ajpasic/Knuckles/Pictures/IMG_0444.JPG

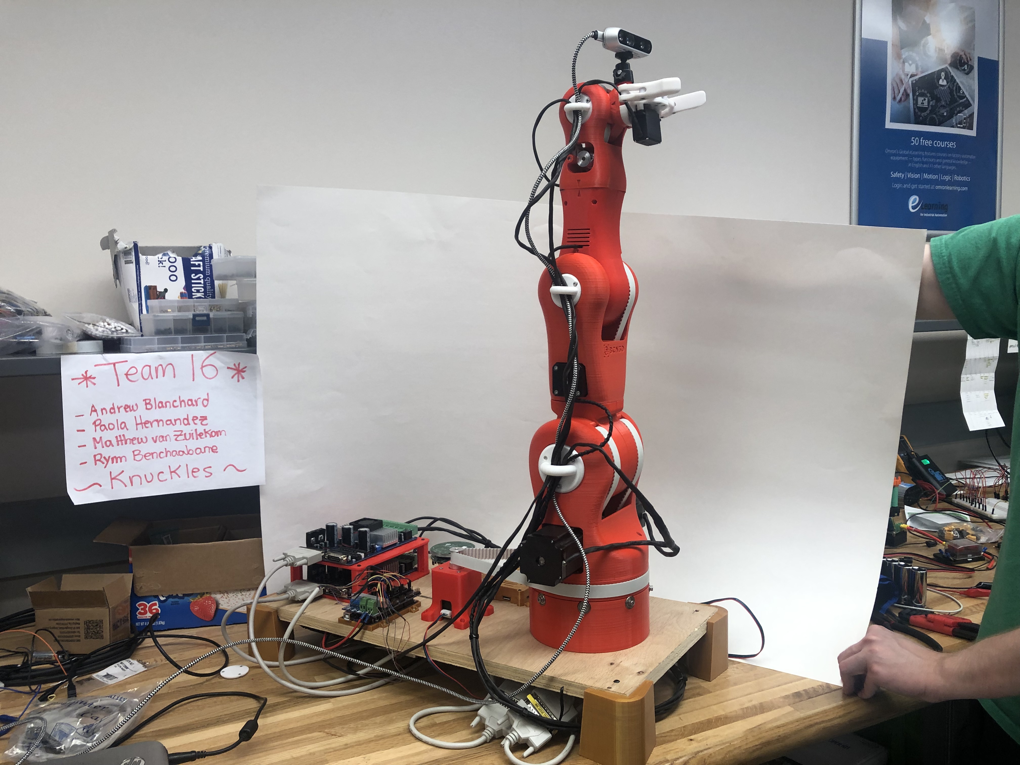
Pictures/IMG_0444.JPG
