ajpasic/Knuckles/Pictures/IMG_0445.JPG

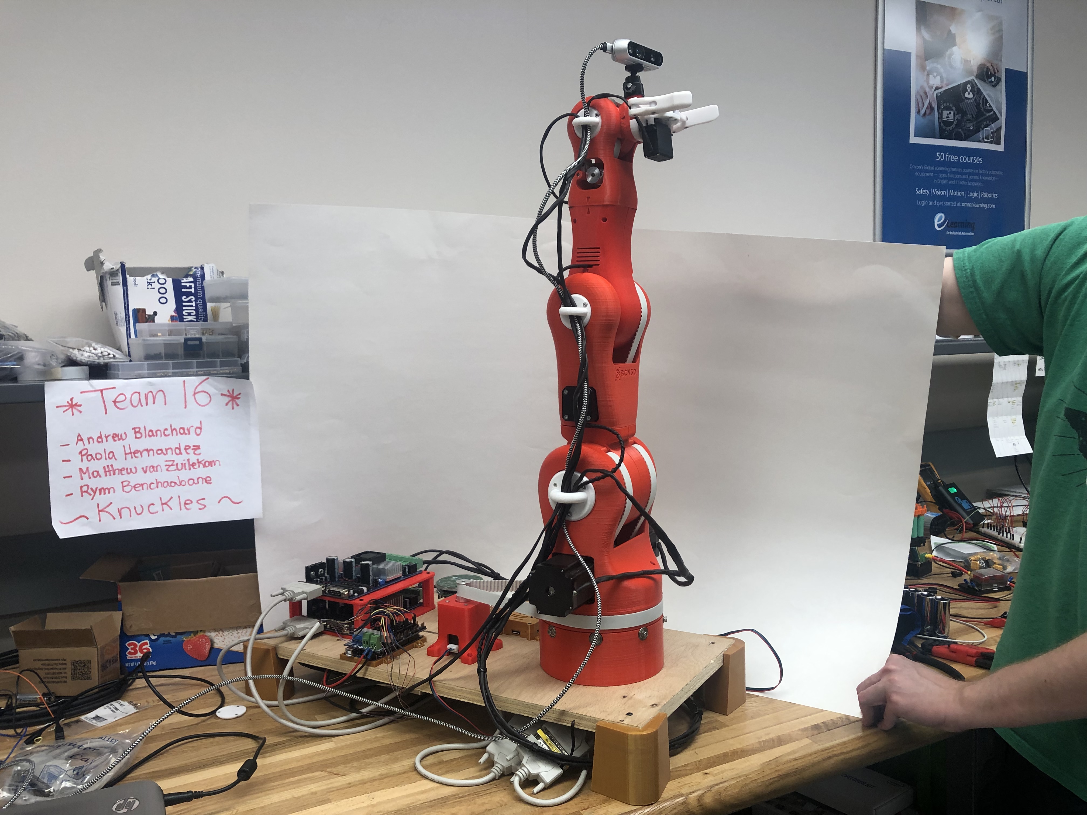
Pictures/IMG_0445.JPG
