ajpasic/Knuckles/README.md

# Knuckles
IEEE/ASME Knuckles Collaboration
