ajpasic/Knuckles/Pictures/IMG_0446.JPG

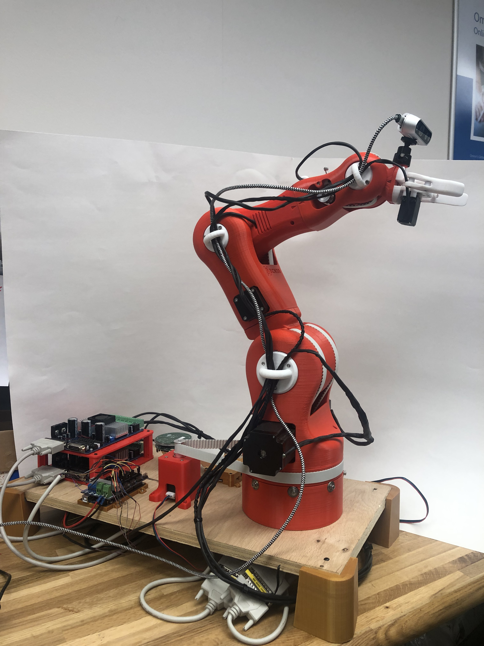
Pictures/IMG_0446.JPG
