ajpasic/Knuckles/Pictures/IMG_0447.JPG

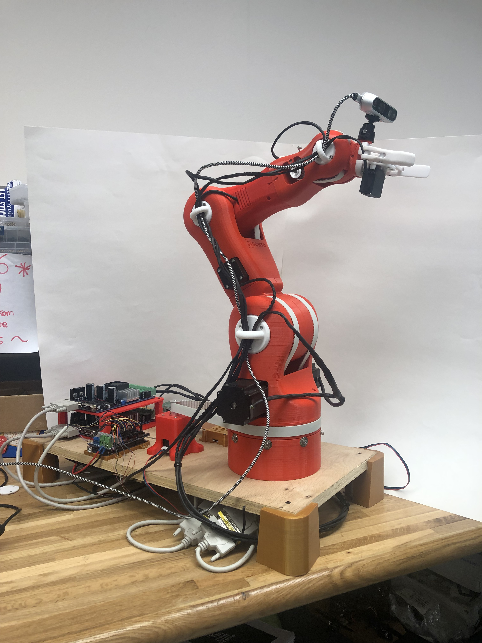
Pictures/IMG_0447.JPG
