ajpasic/Knuckles/Pictures/IMG_0448.JPG

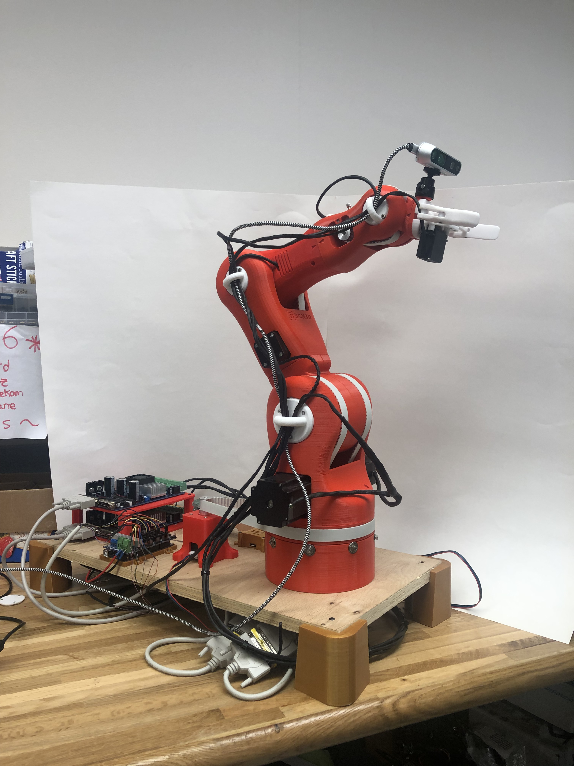
Pictures/IMG_0448.JPG
