ajpasic/Knuckles/Pictures/IMG_0449.JPG

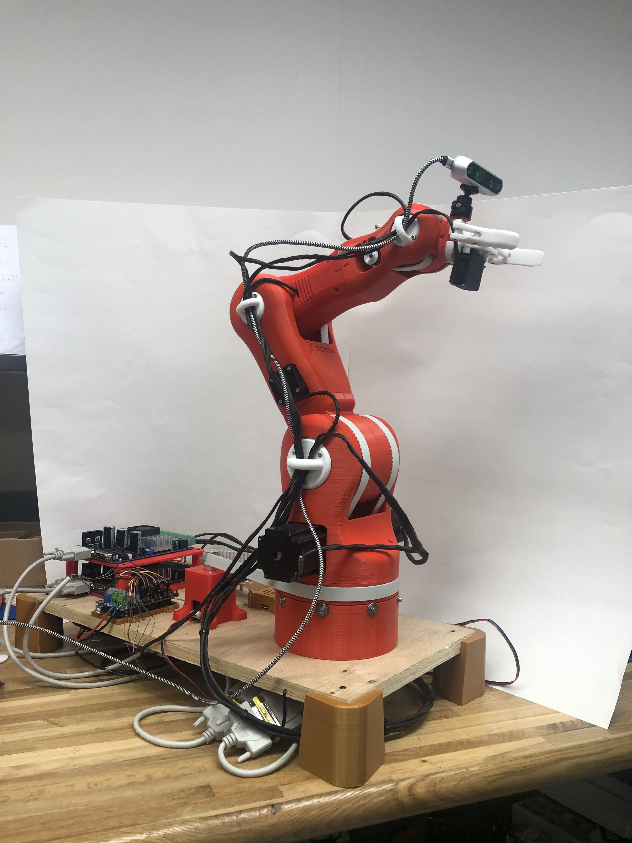
Pictures/IMG_0449.JPG
