ajpasic/Knuckles/Pictures/IMG_0450.JPG

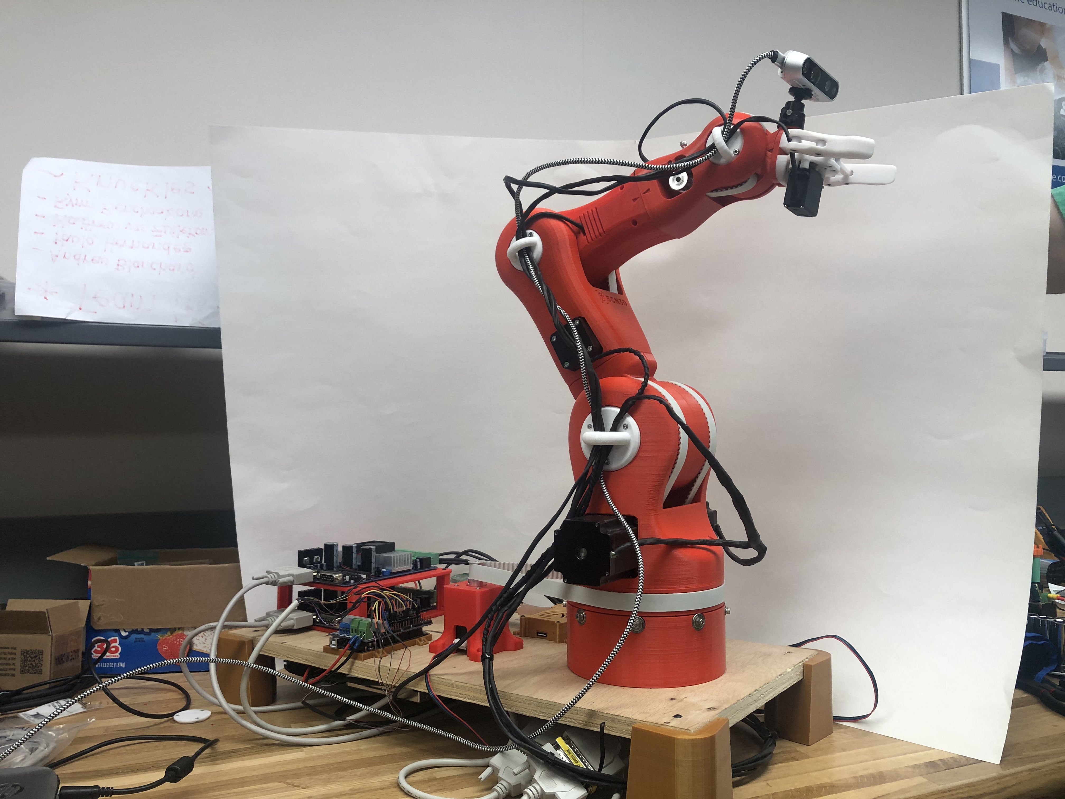
Pictures/IMG_0450.JPG
