ajpasic/Knuckles/Pictures/IMG_0451.JPG

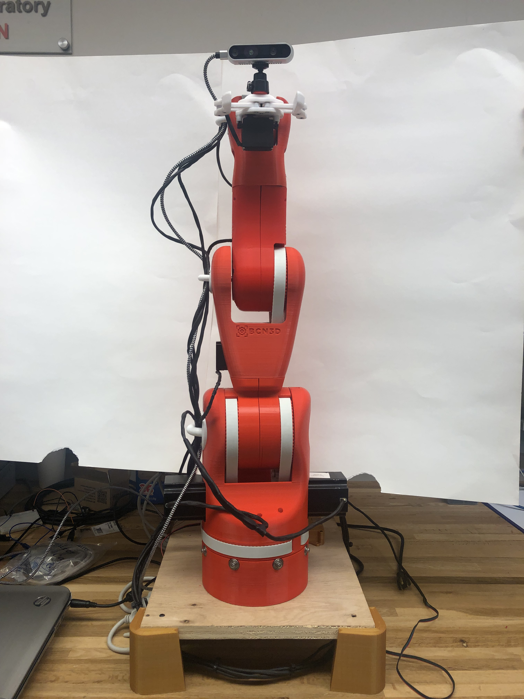
Pictures/IMG_0451.JPG
