ajpasic/Knuckles/Pictures/IMG_0452.JPG

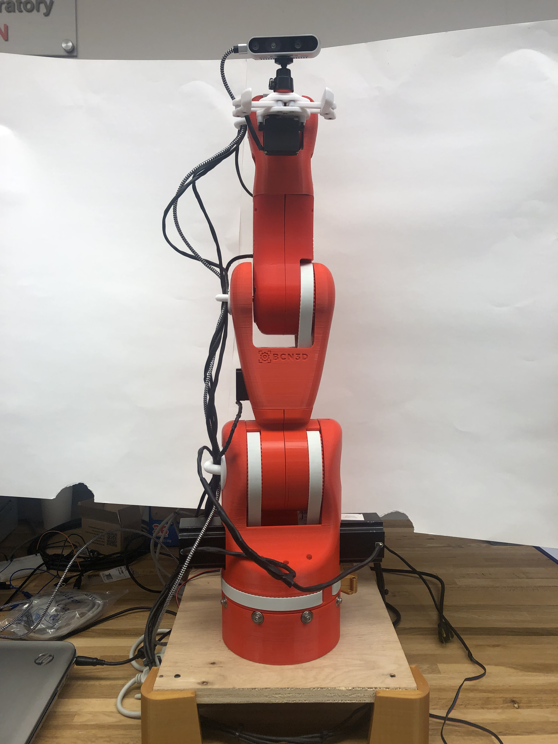
Pictures/IMG_0452.JPG
