ajpasic/Knuckles/Pictures/IMG_0455.JPG

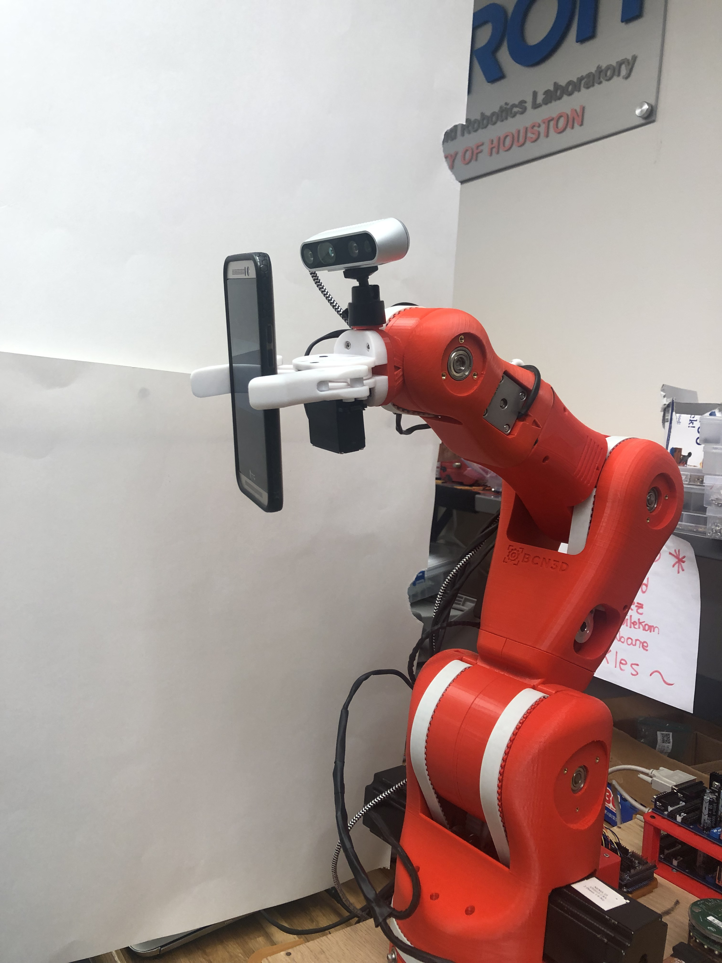
Pictures/IMG_0455.JPG
