ajpasic/Knuckles/Pictures/IMG_0456.JPG

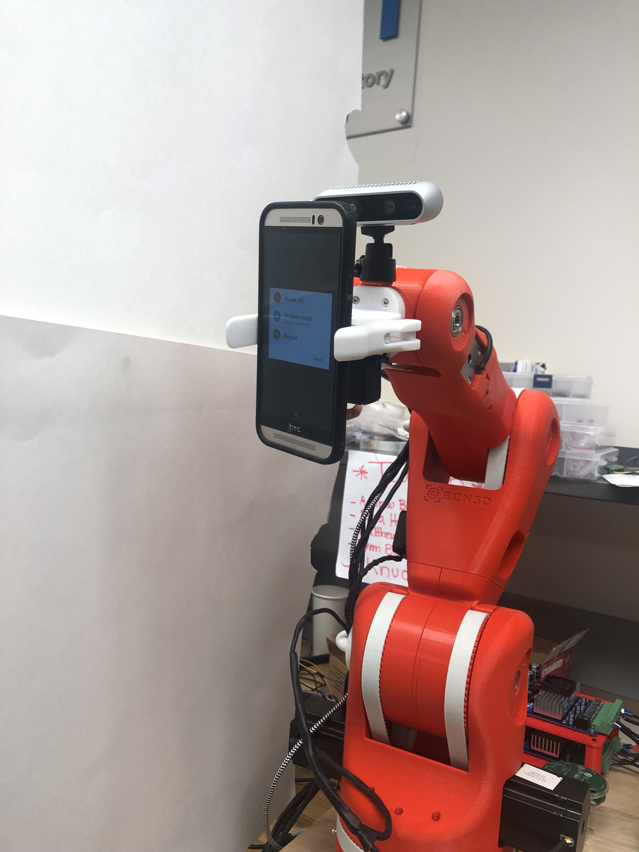
Pictures/IMG_0456.JPG
