ajpasic/Knuckles/Pictures/IMG_0457.JPG

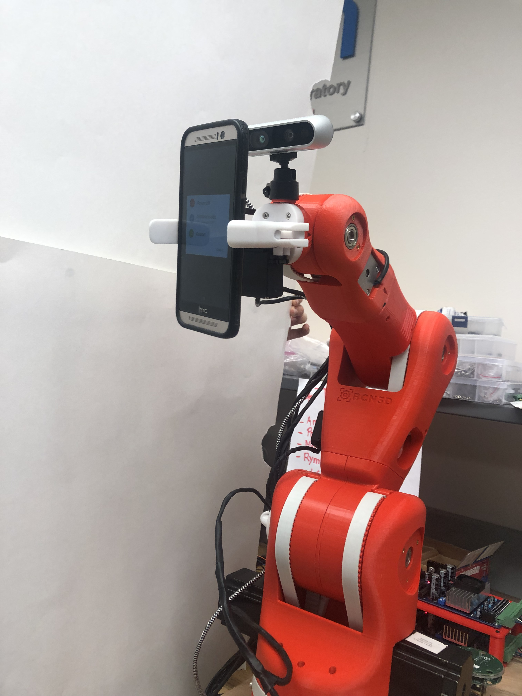
Pictures/IMG_0457.JPG
