ajpasic/Knuckles/Pictures/IMG_0458.JPG

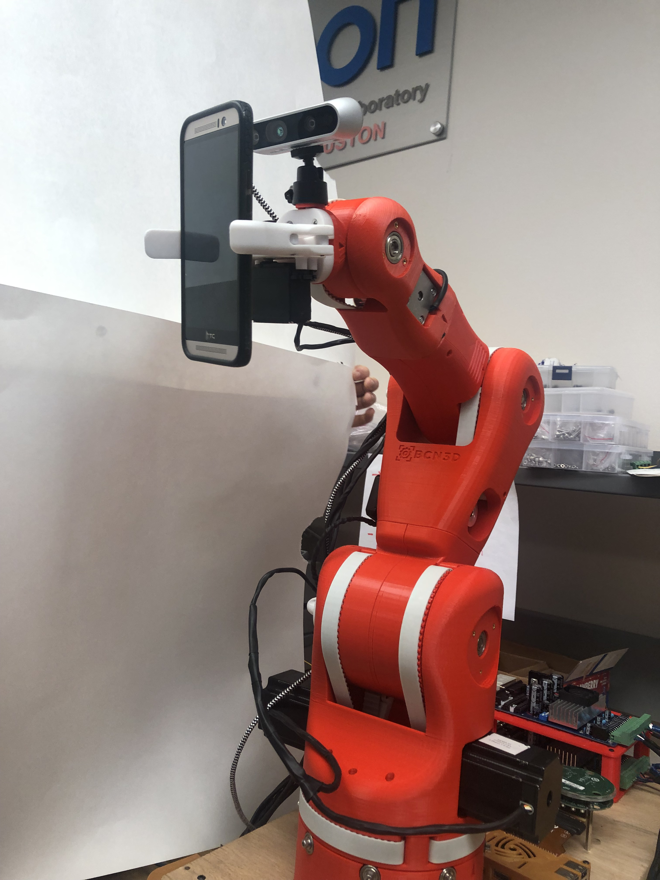
Pictures/IMG_0458.JPG
