ajpasic/Knuckles/Pictures/IMG_0459.JPG

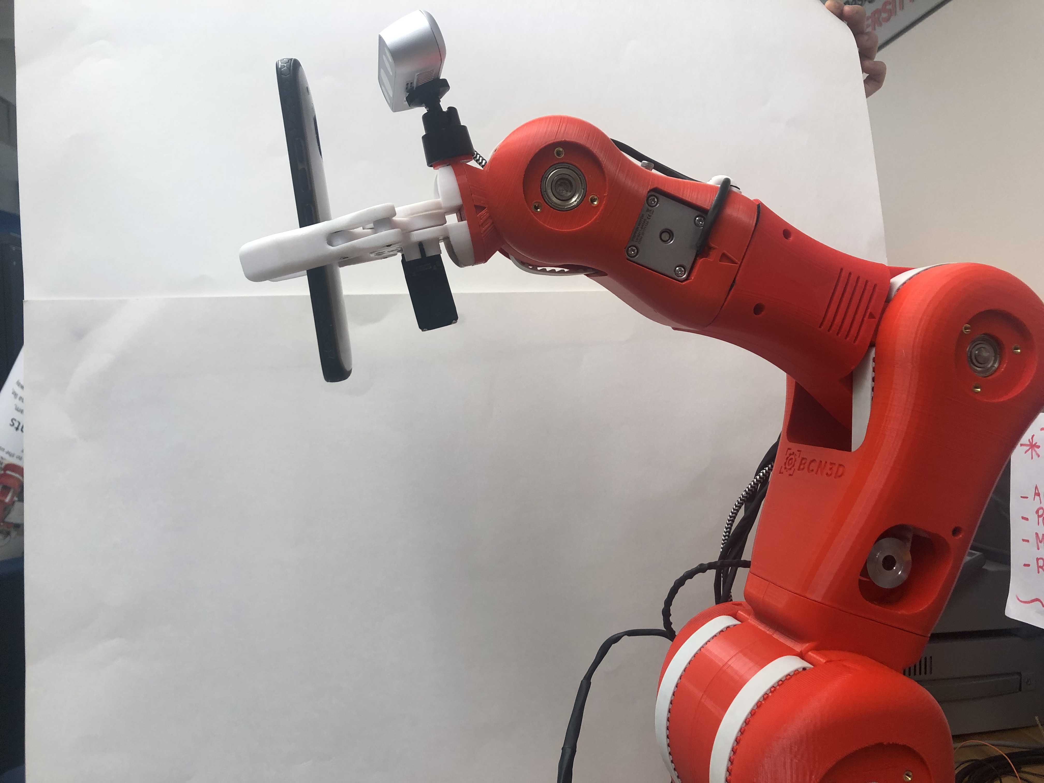
Pictures/IMG_0459.JPG
