ajpasic/Knuckles/Pictures/IMG_0460.JPG

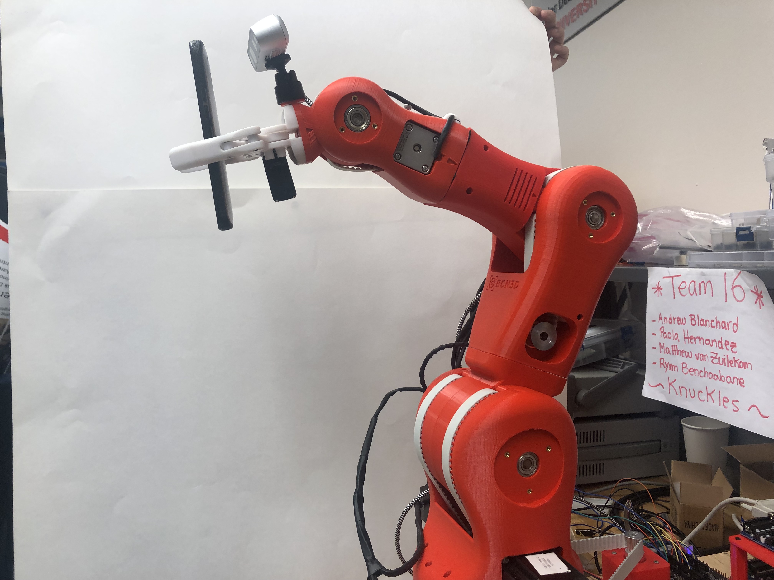
Pictures/IMG_0460.JPG
