ajpasic/Knuckles/Pictures/IMG_0461.JPG

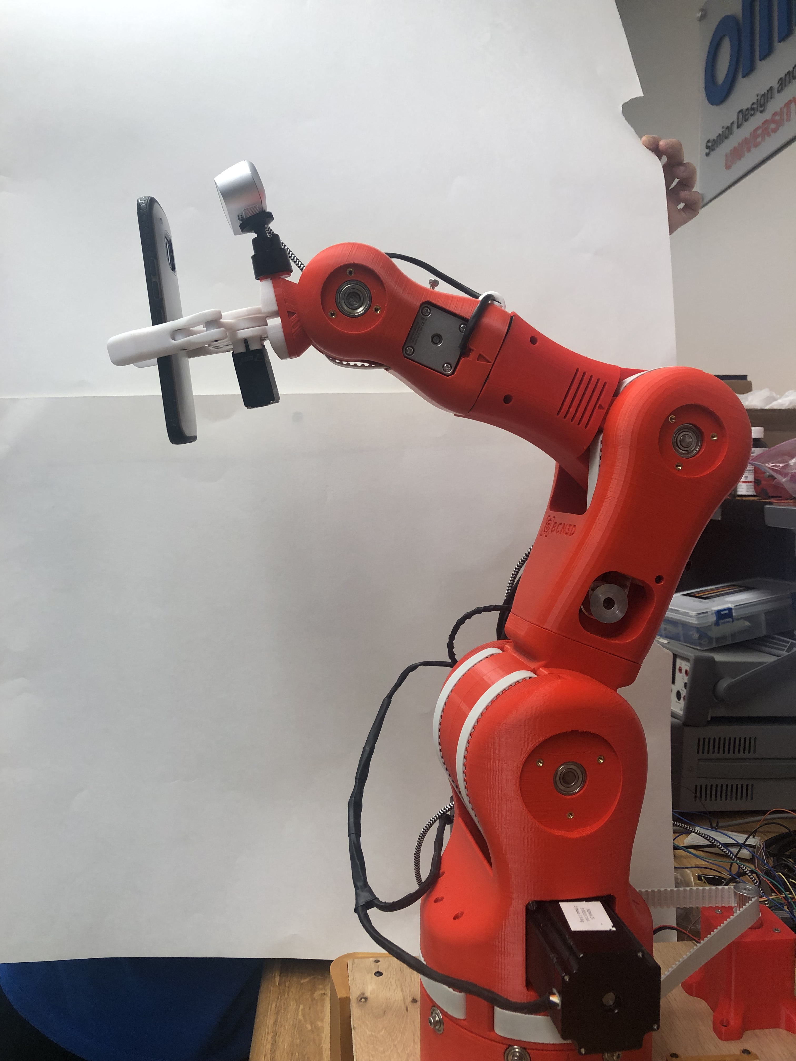
Pictures/IMG_0461.JPG
