ajpasic/Knuckles/Pictures/IMG_0462.JPG

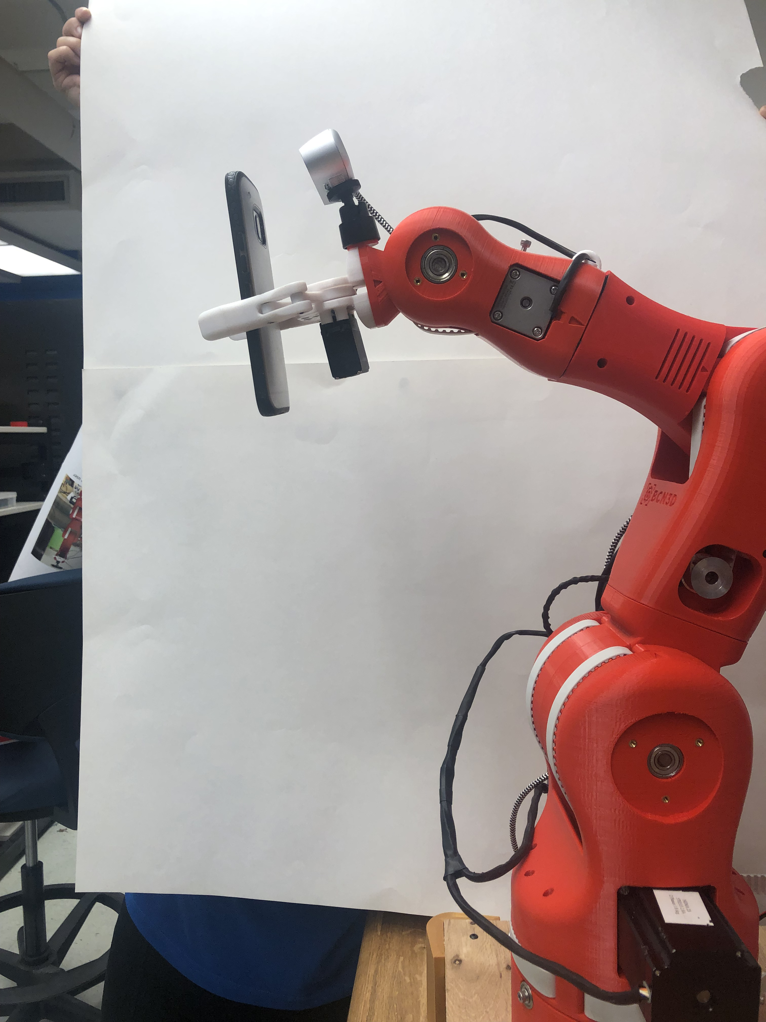
Pictures/IMG_0462.JPG
