ajpasic/Knuckles/Pictures/IMG_0463.JPG

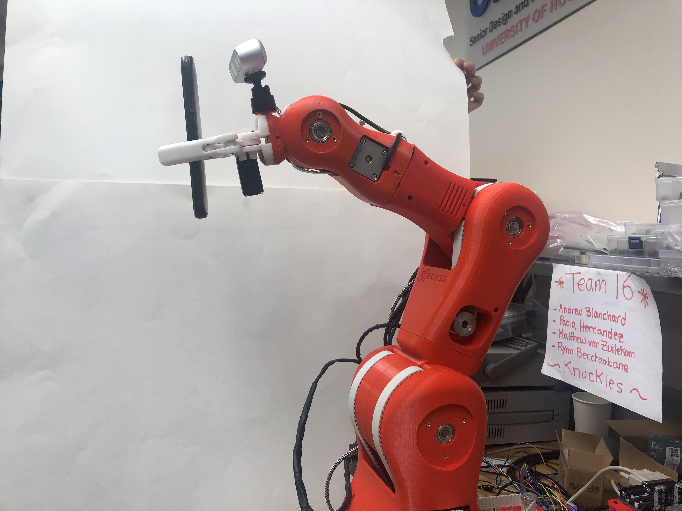
Pictures/IMG_0463.JPG
