ajpasic/Knuckles/Pictures/IMG_0464.JPG

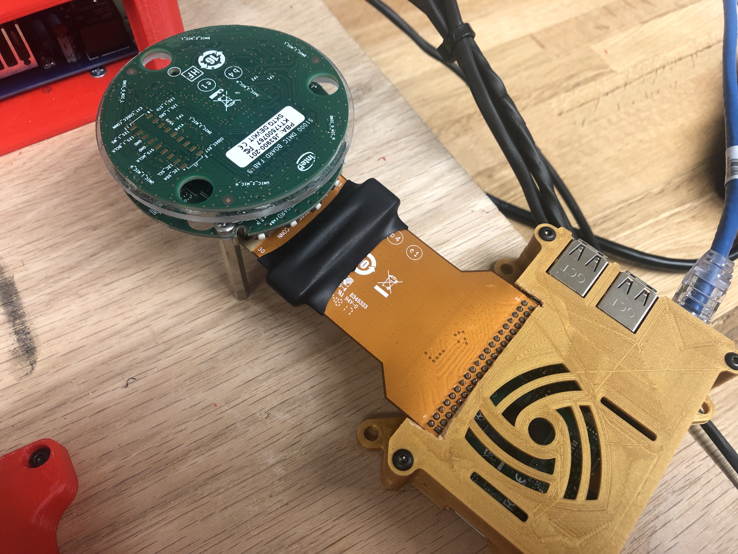
Pictures/IMG_0464.JPG
