ajpasic/Knuckles/Pictures/IMG_0465.JPG

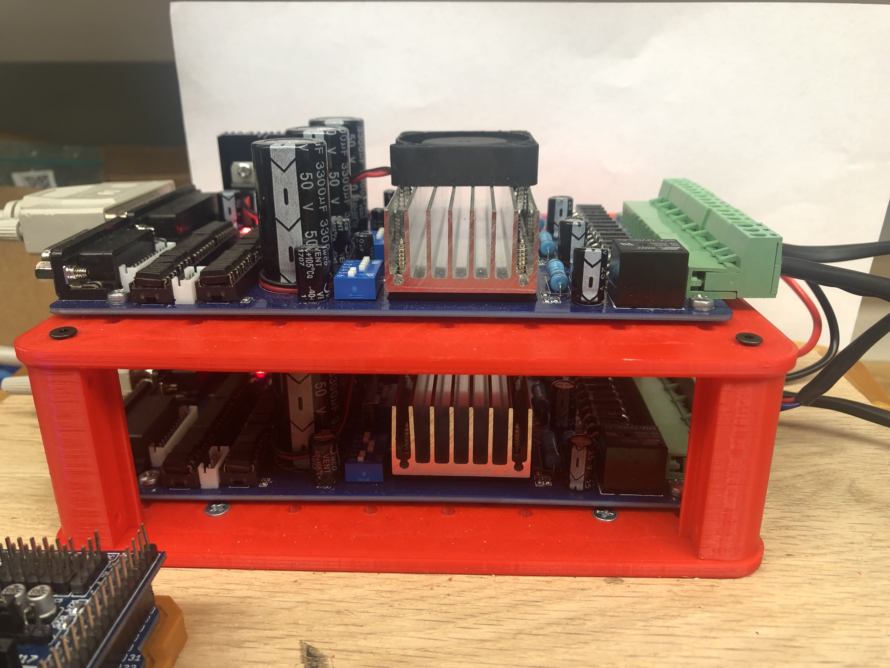
Pictures/IMG_0465.JPG
