ajpasic/Knuckles/Pictures/IMG_0466.JPG

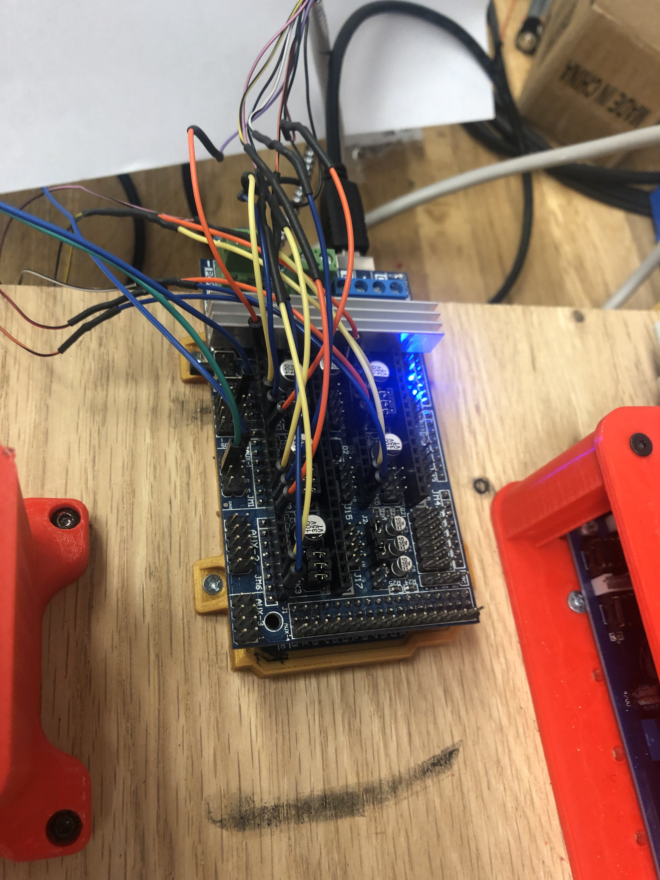
Pictures/IMG_0466.JPG
