ajpasic/Knuckles/Pictures/IMG_0467.JPG

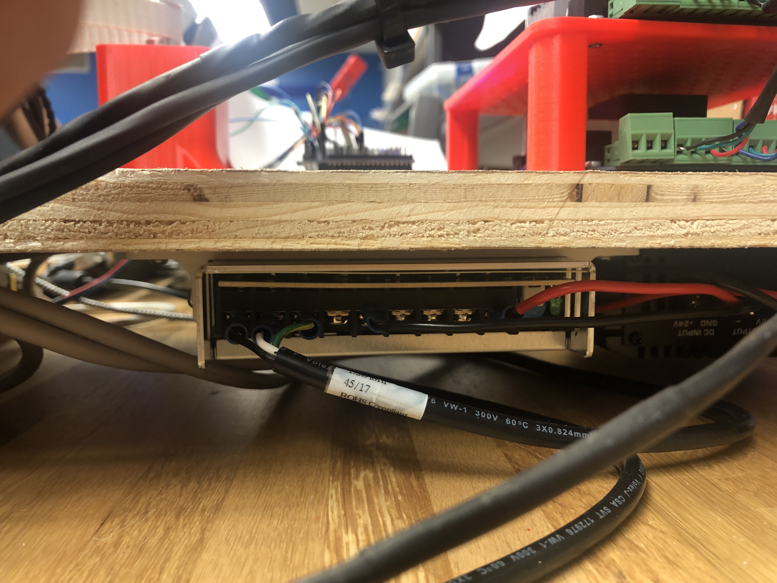
Pictures/IMG_0467.JPG
