ajpasic/Knuckles/roboteurs_stl/arm/arm_body_qty1.STL

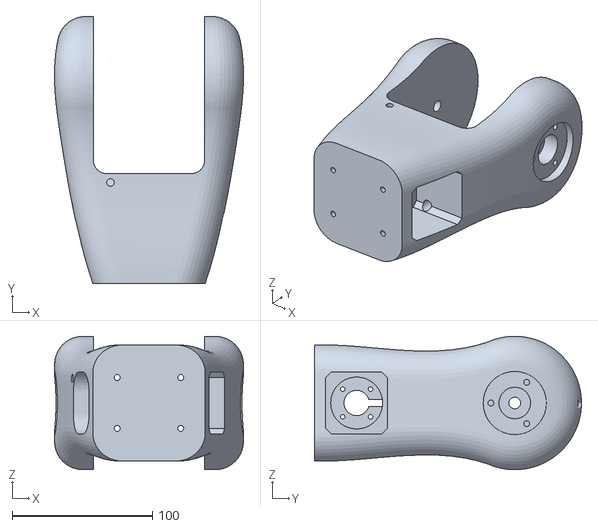
[picture p23: CAD file, 2021-01-31]
roboteurs_stl/arm/arm_body_qty1.STL
134.6 x 190.1 x 95.0
