ajpasic/Knuckles/roboteurs_stl/base/base_qty1.STL

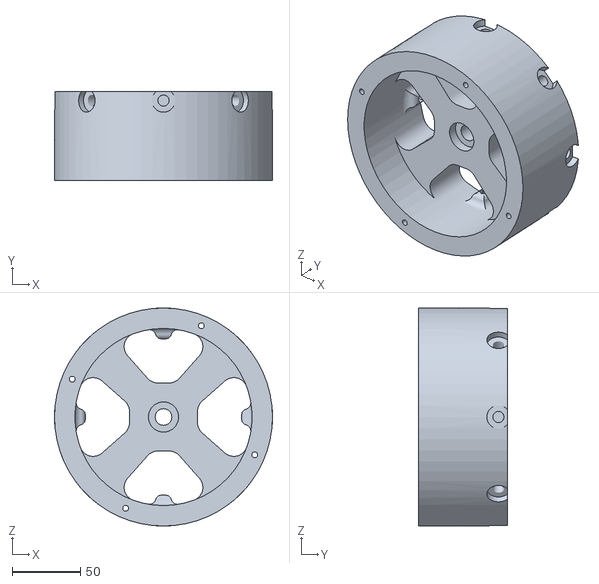
[picture p24: CAD file, 2021-01-31]
roboteurs_stl/base/base_qty1.STL
160.0 x 65.0 x 160.0
