ajpasic/Knuckles/roboteurs_stl/forearm/forearm_left_qty1.STL

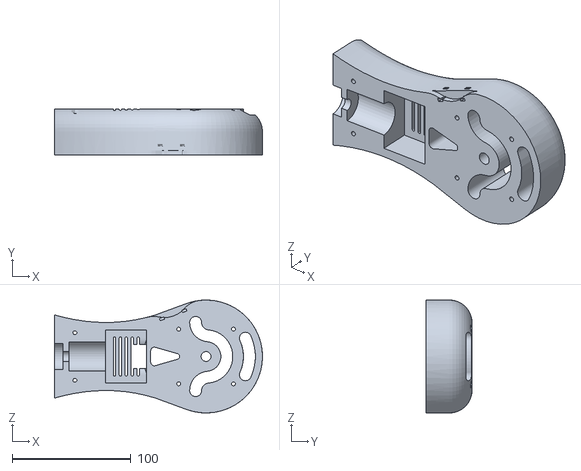
[picture p25: CAD file, 2021-01-31]
roboteurs_stl/forearm/forearm_left_qty1.STL
175.0 x 38.8 x 95.0
