ajpasic/Knuckles/roboteurs_stl/gripper/finger_link_qty2.STL

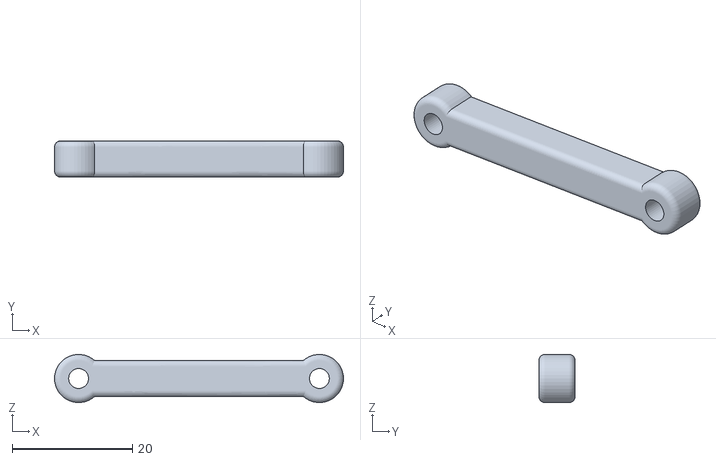
[picture p26: CAD file, 2021-01-31]
roboteurs_stl/gripper/finger_link_qty2.STL
48.0 x 6.00 x 7.99
