ajpasic/Knuckles/roboteurs_stl/shoulder/shoulder_tensioner_left_qty1.STL

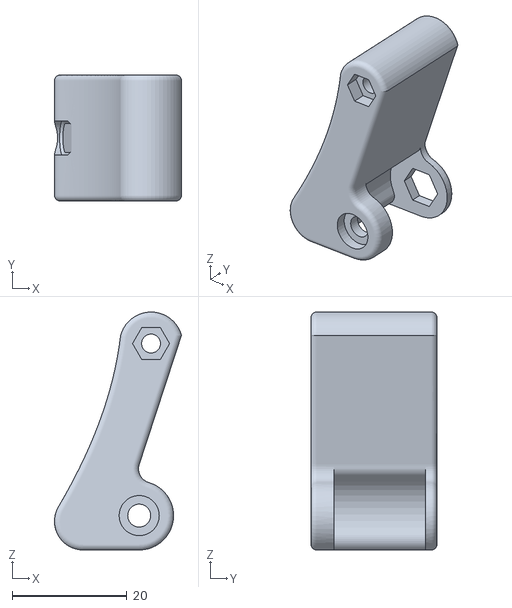
[picture p27: CAD file, 2021-01-31]
roboteurs_stl/shoulder/shoulder_tensioner_left_qty1.STL
22.2 x 22.0 x 41.5
