ajpasic/Knuckles/roboteurs_stl/wrist/wrist_gear_right_qty1.STL

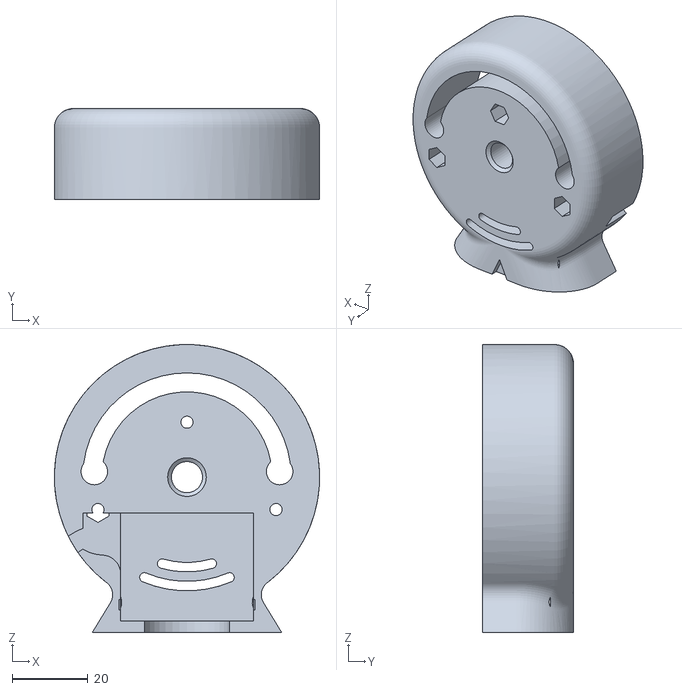
[picture p28: CAD file, 2021-01-31]
roboteurs_stl/wrist/wrist_gear_right_qty1.STL
70.0 x 24.0 x 76.0
