ajpasic/Knuckles/roboteurs_stl/arm/arm_body_split_bottom.STL

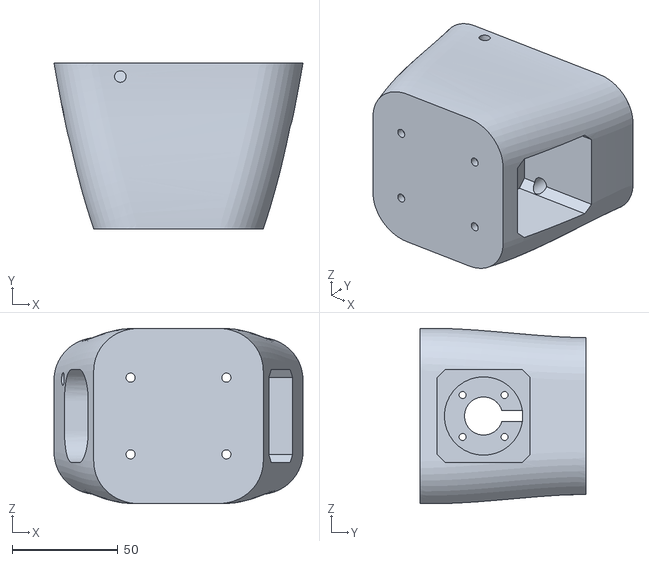
[picture p29: CAD file, 2021-01-31]
roboteurs_stl/arm/arm_body_split_bottom.STL
117.5 x 78.3 x 82.8
