ajpasic/Knuckles/roboteurs_stl/base/base_gear_qty1.STL

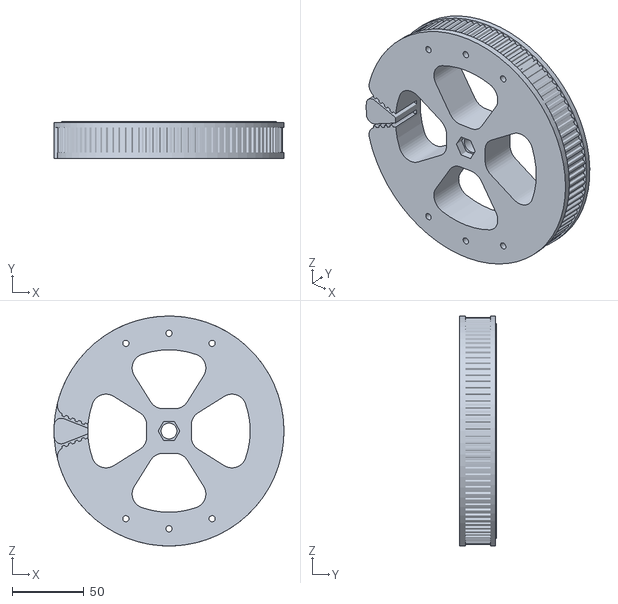
[picture p30: CAD file, 2021-01-31]
roboteurs_stl/base/base_gear_qty1.STL
160.0 x 25.5 x 160.0
