ajpasic/Knuckles/roboteurs_stl/gripper/gripper_top_plate_qty1.STL

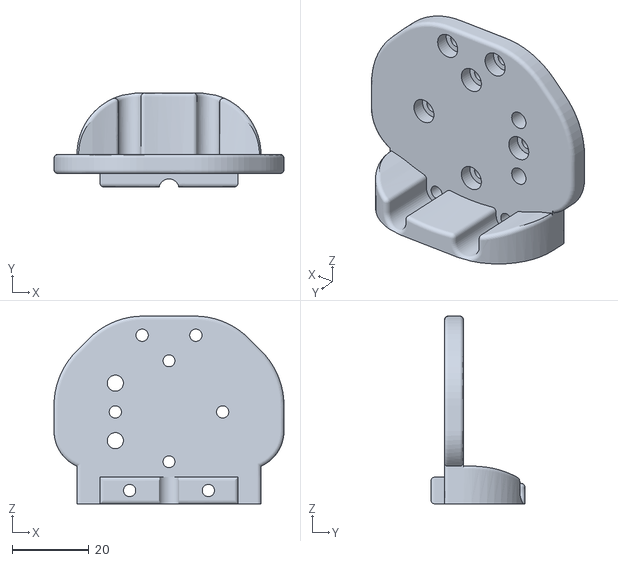
[picture p32: CAD file, 2021-01-31]
roboteurs_stl/gripper/gripper_top_plate_qty1.STL
60.0 x 24.5 x 49.0
