ajpasic/Knuckles/roboteurs_stl/shoulder/shoulder_gear_left_qty1.STL

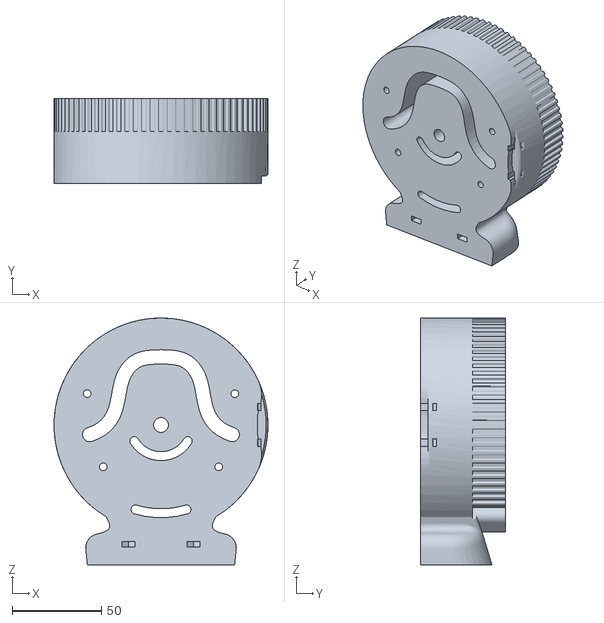
[picture p33: CAD file, 2021-01-31]
roboteurs_stl/shoulder/shoulder_gear_left_qty1.STL
120.0 x 47.5 x 138.5
