ajpasic/Knuckles/roboteurs_stl/arm/arm_tensioner_qty1.STL

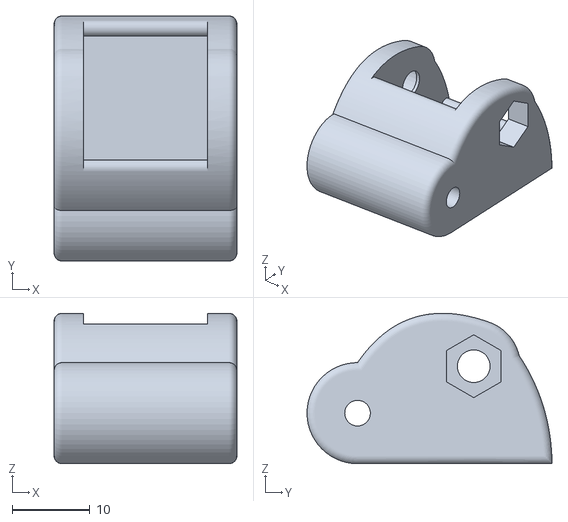
[picture p34: CAD file, 2021-01-31]
roboteurs_stl/arm/arm_tensioner_qty1.STL
23.5 x 31.5 x 19.3
