ajpasic/Knuckles/roboteurs_stl/base/base_motor_bracket_qty1.STL

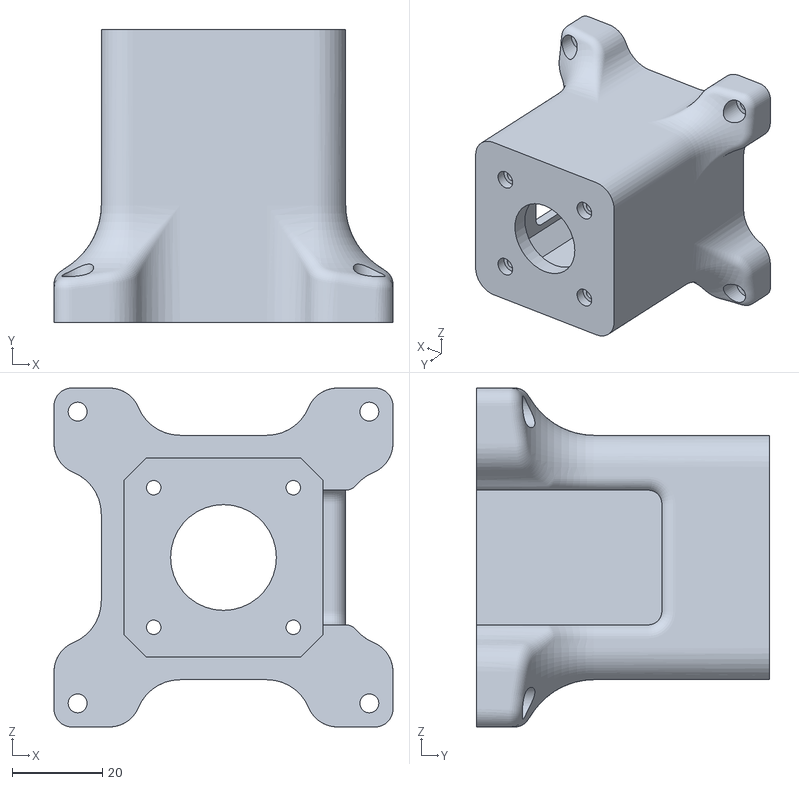
[picture p35: CAD file, 2021-01-31]
roboteurs_stl/base/base_motor_bracket_qty1.STL
75.3 x 65.0 x 75.3
