ajpasic/Knuckles/roboteurs_stl/gripper/finger_right_qty1.STL

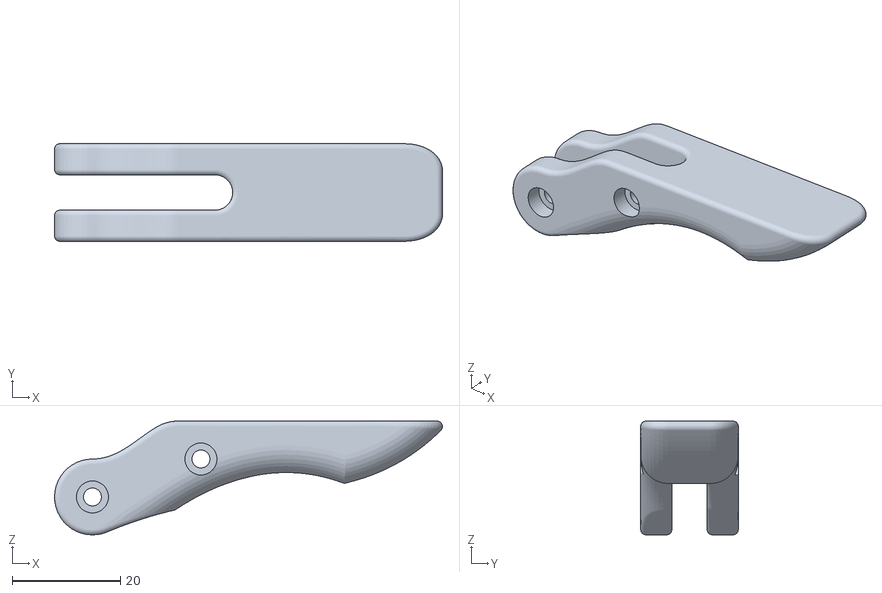
[picture p36: CAD file, 2021-01-31]
roboteurs_stl/gripper/finger_right_qty1.STL
71.5 x 18.0 x 21.0
