ajpasic/Knuckles/roboteurs_stl/shoulder/shoulder_split_top.STL

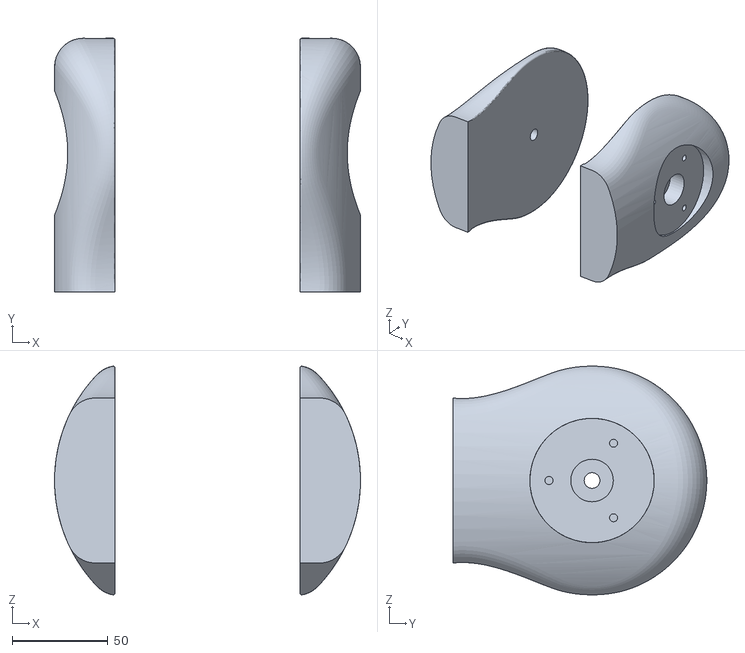
[picture p37: CAD file, 2021-01-31]
roboteurs_stl/shoulder/shoulder_split_top.STL
160.0 x 132.6 x 119.6
