ajpasic/Knuckles/roboteurs_stl/wrist/wrist_cap_small_qty2.STL

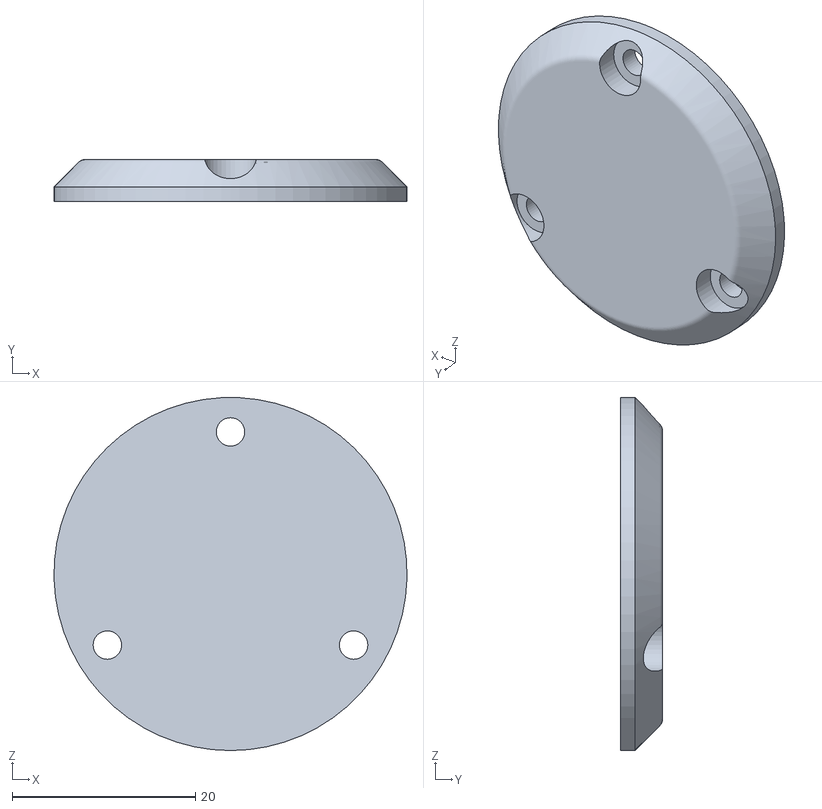
[picture p38: CAD file, 2021-01-31]
roboteurs_stl/wrist/wrist_cap_small_qty2.STL
38.5 x 4.60 x 38.5
