ajpasic/Knuckles/roboteurs_stl/arm/arm_body_split_top.STL

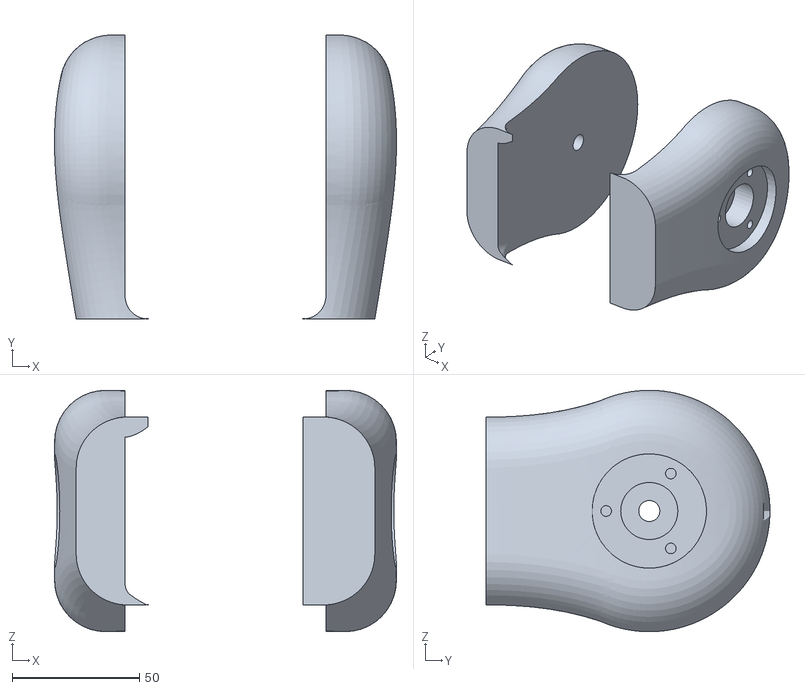
[picture p39: CAD file, 2021-01-31]
roboteurs_stl/arm/arm_body_split_top.STL
134.6 x 111.8 x 95.0
