ajpasic/Knuckles/roboteurs_stl/gripper/gripper_bottom_plate_qty1.STL

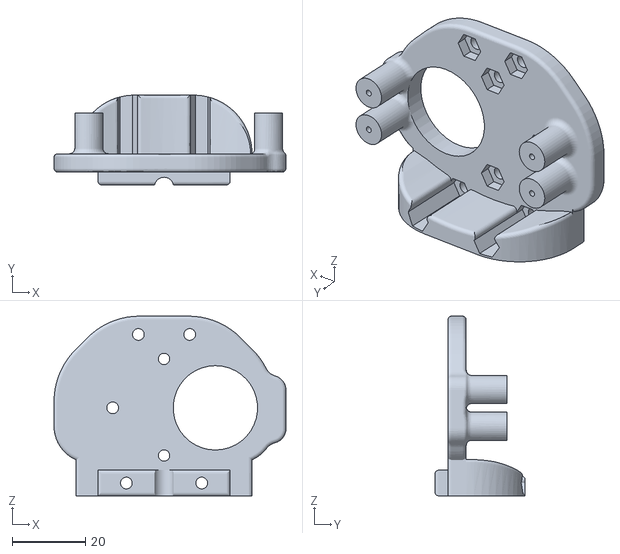
[picture p40: CAD file, 2021-01-31]
roboteurs_stl/gripper/gripper_bottom_plate_qty1.STL
63.2 x 24.5 x 49.0
