ajpasic/Knuckles/roboteurs_stl/shoulder/shoulder_split_bottom.STL

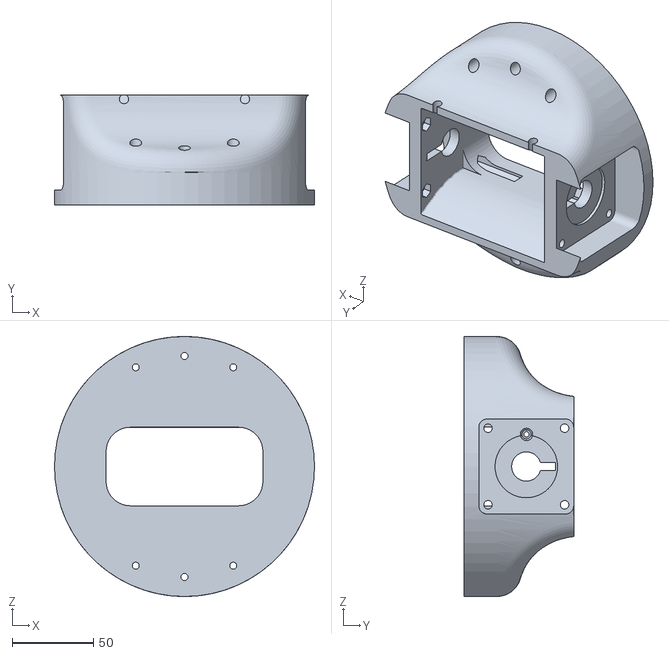
[picture p41: CAD file, 2021-01-31]
roboteurs_stl/shoulder/shoulder_split_bottom.STL
160.0 x 67.4 x 160.0
