ajpasic/Knuckles/roboteurs_stl/wrist/wrist_bearing_cap_qty1.STL

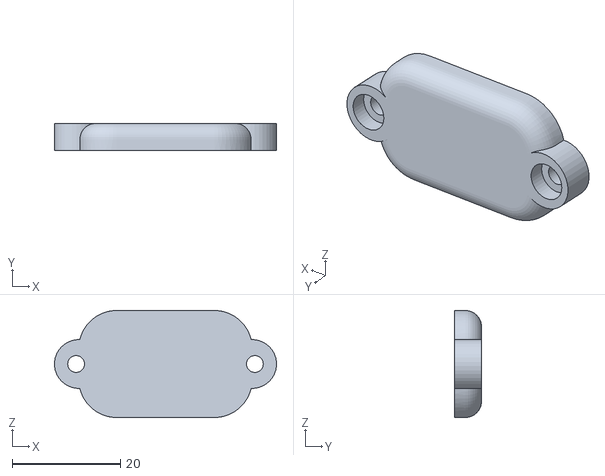
[picture p42: CAD file, 2021-01-31]
roboteurs_stl/wrist/wrist_bearing_cap_qty1.STL
41.0 x 5.00 x 19.8
