ajpasic/Knuckles/roboteurs_stl/arm/arm_bearing_cap_qty2.STL

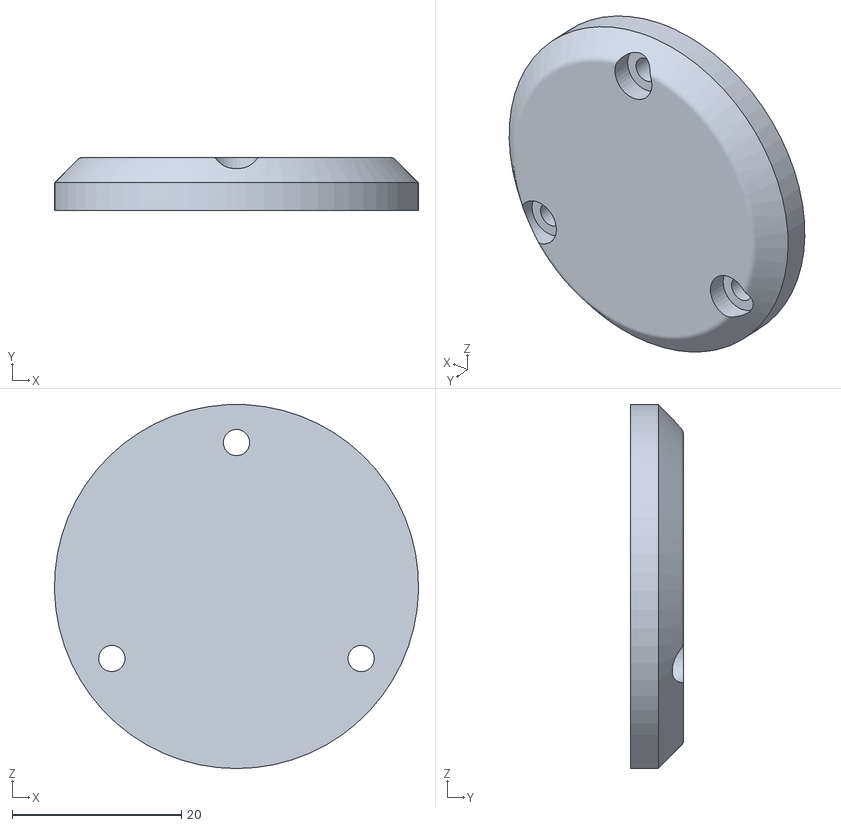
[picture p43: CAD file, 2021-01-31]
roboteurs_stl/arm/arm_bearing_cap_qty2.STL
43.0 x 6.30 x 43.0
