ajpasic/Knuckles/roboteurs_stl/wrist/wrist_tensioner_qty1.STL

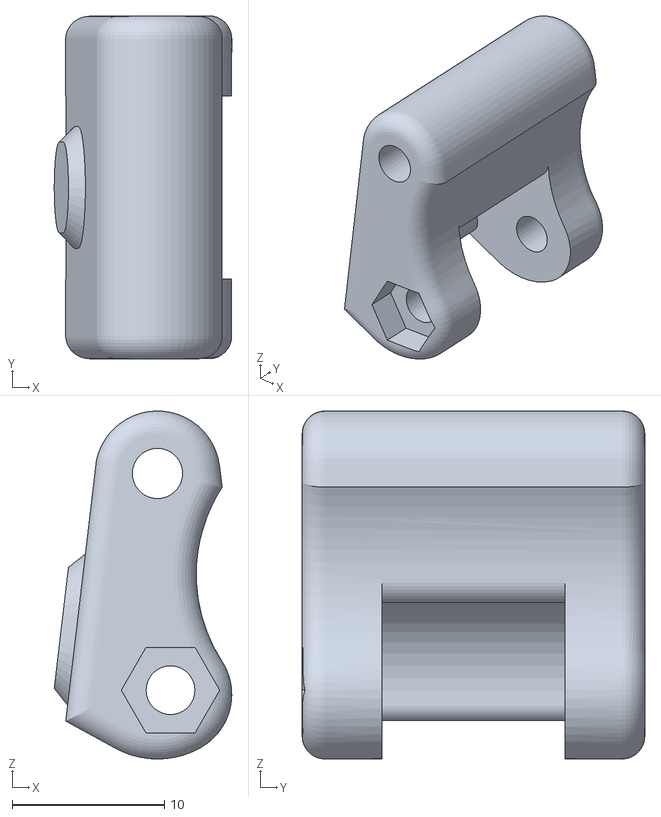
[picture p46: CAD file, 2021-01-31]
roboteurs_stl/wrist/wrist_tensioner_qty1.STL
11.7 x 22.5 x 22.9
