ajpasic/Knuckles/roboteurs_stl/shoulder/shoulder_bearing_cap_qty2.STL

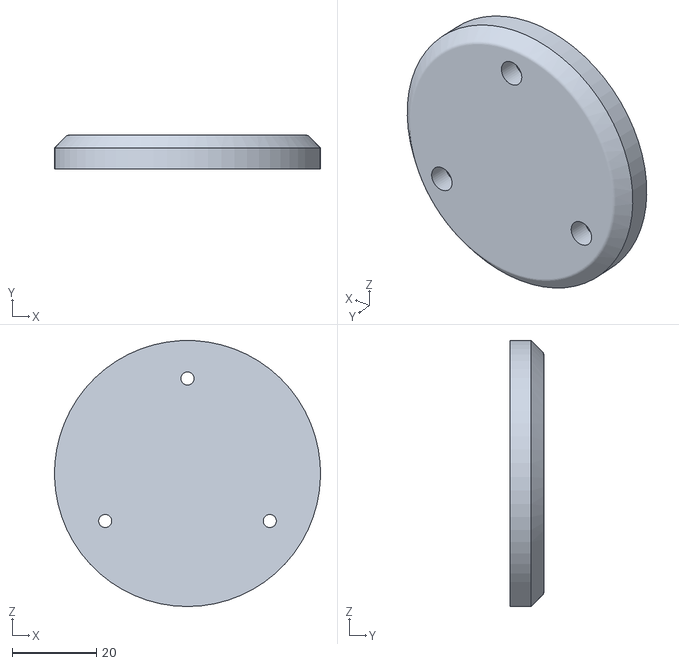
[picture p47: CAD file, 2021-01-31]
roboteurs_stl/shoulder/shoulder_bearing_cap_qty2.STL
63.0 x 8.00 x 63.0
