ajpasic/Knuckles/(list of files, cad)

Other CAD files:
roboteurs_stl/wrist/wrist_body_qty1.STL
roboteurs_stl/gripper/finger_left_qty1.STL
roboteurs_stl/shoulder/shoulder_gear_right_qty1.STL
