ajpasic/Knuckles/TODO.md

### Week of November 6
1. Watch all videos posted in the Discord channel
2. Create a rigid body tree model (3 limbs, 3 joints)
3. Perform inverse kinematics to find pose
4. Implement this in a graphic interface with MATLAB App Designer
