ajpasic/Knuckles/(commit log)

2021-01-30 imported senior design documentation
    [14mmbore.stl, 1M1.STL, 1M1B.STL, 1M2.STL, 1M2A.STL, 1M2B.STL, 1M2B_Cover.STL, 1M3A.STL]
2021-01-31 added .stl files from Roboteurs site
    [arm_bearing_cap_qty2.STL, arm_body_qty1.STL, arm_body_split_bottom.STL, arm_body_split_top.STL, arm_tensioner_qty1.STL, base_gear_qty1.STL, base_motor_bracket_qty1.STL, base_qty1.STL]
2021-01-31 removed senior design documentation
    [14mmbore.stl, 1M1.STL, 1M1B.STL, 1M2.STL, 1M2A.STL, 1M2B.STL, 1M2B_Cover.STL, 1M3A.STL]
2021-01-31 added assembly and setup guides
